karmazin-i-m/clock/(list of files, cad)

Other CAD files:
Autocad_Model/1x12 2.54 pin mother/1x12 2.54 pin mother.dwg
Autocad_Model/Clock Model/Clock Middle Part.dwg
Autocad_Model/GNM-23881.dwg
Autocad_Model/GNM-23881/GNM-23881.dwg
Autocad_Model/Border with small stamp A4.dwg
Autocad_Model/Clock Model/Clock Button.dwg
Autocad_Model/Border with big stamp A4.dwg
Autocad_Model/Clock Model/Clock model.dwg
Autocad_Model/Clock Model/Clock Back Cover.dwg
Autocad_Model/Clock Model/Clock Facade.dwg
