karmazin-i-m/clock/(list of files, drawings)

Other design files:
Clock/Arduino Nano 3/Arduino Nano 3.pdsprj
