karmazin-i-m/clock/Clock_Arduino/Clock_Arduino.ino

// Board variant. Set to 0 for a board fitted with a BMP280, which measures
// temperature and pressure but has no humidity sensor. Guarded so a build can
// override it, e.g. arduino-cli --build-property
// compiler.cpp.extra_flags=-DHAS_HUMIDITY=0
#ifndef HAS_HUMIDITY
#define HAS_HUMIDITY 1
#endif

#include <DS3231.h>
#include <Adafruit_Sensor.h>
#if HAS_HUMIDITY
#include <Adafruit_BME280.h>
#else
#include <Adafruit_BMP280.h>
#endif
#include <Wire.h>
#include <EEPROM.h>
#include <avr/pgmspace.h>

#define ButtonPin 2
#define LatchPin 4
#define ClockPin 3
#define AnodeDataPin 5
#define CatodeDataPin 7
#define CatodeClockPin 6

#define RENDER_LINE_COUNT 8

#if HAS_HUMIDITY
#define MARQUEE_PAGE_COUNT 5
#else
#define MARQUEE_PAGE_COUNT 4
#endif
#define MARQUEE_PAGE_BYTES 3
#define MARQUEE_STRIP_BYTES (MARQUEE_PAGE_COUNT * MARQUEE_PAGE_BYTES)
#define MARQUEE_PAGE_COLUMNS 24
#define MARQUEE_TOTAL_STEPS ((MARQUEE_PAGE_COUNT - 1) * MARQUEE_PAGE_COLUMNS)
#define MARQUEE_STEP_MS 80
#define MARQUEE_HOLD_MS 5000
#define MARQUEE_PERIOD_MINUTES 5

// Rows are advanced by Timer1, not by loop(), so the slot really is fixed and
// brightness no longer depends on what else the pass happened to do. Dimming is
// simply a shorter lit fraction of that same slot, which leaves the frame rate
// alone. Timer1 runs on the /8 prescaler, so one tick is 0.5 us at 16 MHz.
#define ROW_PERIOD_US 500
#define ROW_ON_BRIGHT_US 450
#define ROW_ON_DIM_US 60
#define TIMER1_TICKS_PER_US 2
#define ROW_PERIOD_TICKS (ROW_PERIOD_US * TIMER1_TICKS_PER_US)
#define FRAME_PERIOD_MS ((ROW_PERIOD_US * 8UL) / 1000)

// Defaults only. The ESP-01 can change the dimming window and the marquee
// period over the link, and what it sets is kept in EEPROM, so these are what a
// blank chip starts from.
#define DIM_FROM_HOUR 22
#define DIM_UNTIL_HOUR 7

#define CLOCK_POLL_MS 100
// Every sensor read is blocking I2C in the gap between two frames, so it costs
// the panel a dark window and shows up as a brightness dip. At one second the
// dip was a visible flicker and it bought nothing: the sensor itself converts
// in ~112 ms and every screen rounds to whole degrees, mmHg and percent.
#define SENSOR_POLL_MS 10000

// The ESP-01 on the hardware UART. Frames are one line of ASCII ending in a XOR
// checksum, and anything that fails it is dropped without a reply - the ESP's
// boot ROM talks at 74880 baud on this same wire every time it starts, and that
// noise must never be mistaken for a command.
//
// A reply has to fit in the 64 byte hardware transmit buffer - 63 usable - or
// Serial.print blocks loop() until the wire drains, at about a millisecond a
// byte. Two replies can leave in one pass, because the ESP polls for readings
// and settings on schedules that coincide, so the pair is what has to fit: a
// status frame is at most 40 bytes on the wire and a config frame 16.
#define LINK_BAUD 9600
#define LINK_BUFFER 48

// Signature, version, then the three settable bytes. A chip that does not carry
// the signature keeps the compiled defaults rather than three bytes of 0xFF.
#define CONFIG_ADDRESS 0
#define CONFIG_SIGNATURE_A 'K'
#define CONFIG_SIGNATURE_B 'C'
#define CONFIG_VERSION 1

// Twelve samples a quarter of an hour apart give the three hour window that
// pressure trends are conventionally read over.
#define PRESSURE_HISTORY 12
#define PRESSURE_SAMPLE_MS 900000UL
#define PRESSURE_TREND_MMHG 1

// One click steps through the screens. Holding does something only on the clock
// screen, where it opens time programming, and inside programming, where it moves
// to the next field. Entering takes the full three seconds so it cannot happen by
// accident; once inside, a second is enough and keeps setting a time bearable.
//
// The button is wired active HIGH. D2 was measured idling LOW in 100% of samples
// with the internal pull-up enabled and nothing pressed, and with zero edges, so
// an external pull-down holds the line and pressing lifts it. Reading it the other
// way round makes the firmware believe the button is held from the moment it boots.
#define BUTTON_PRESSED_LEVEL HIGH

#define BUTTON_DEBOUNCE_MS 25
#define BUTTON_HOLD_MS 3000
#define BUTTON_FIELD_HOLD_MS 1000

// Ten seconds, which is deliberately nowhere near the three that open time
// programming: this is the escape hatch for a router that was replaced, and it
// throws away a working network, so it must not be reachable by holding a
// moment too long.
#define BUTTON_RESET_HOLD_MS 10000

// The longest silence the ESP may ask for. Generous enough to cover walking the
// module into its bootloader by hand, and short enough that a frame sent by
// mistake cannot take the clock off the wire for the rest of the day.
#define LINK_MUTE_MAX_SECONDS 600

// A sensor screen returns to the clock once the button has been left alone this
// long. Programming is exempt: it is a deliberate mode the user is standing in
// front of, and dropping out of it mid-edit would be worse than waiting.
#define IDLE_RETURN_MS 30000

#if HAS_HUMIDITY
#define DISPLAY_MODE_COUNT 4
#else
#define DISPLAY_MODE_COUNT 3
#endif

const int times = 0;
const int temperature = 1;
const int pressure = 2;
#if HAS_HUMIDITY
const int humidity = 3;
#endif
const int altitude = 4;
const int marquee = 5;
const int settings = 100;
const int minuteMinorSettings = 101;
const int minuteMajorSettings = 102;
const int hourMinorSettings = 103;
const int hourMajorSettings = 104;
const int endSettings = 105;

const int colon = 10;
const int degree = 11;
const int celsius = 12;
const int pressureSymbol= 13;
const int nullNumber = 14;
const int percent = 15;
const int trendUp = 16;
const int trendDown = 17;
const int trendSteady = 18;

void commitFrame();
static void startRendering();
void timeArrayFilling(int hour1 = nullNumber, int hour2 = nullNumber, int minute1 = nullNumber, int minute2 = nullNumber, int separator = colon);
void pressureArrayFiling(int pressure1, int pressure2, int pressure3, int trend = nullNumber);
void temperatureArrayFiling(int temperature1, int temperature2);
int concatenateInt(int major, int minor);
void updateButton(unsigned long now);
void buttonClick();
void buttonHold();
void readSensors();
void recordPressureSample();
int pressureTrendGlyph();
#if HAS_HUMIDITY
void humidityArrayFiling(int humidity1, int humidity2);
#endif
void startMarquee();
void marqueeCapturePage(int page);
void marqueeRender();
void updateLink();
void linkSend(const char *payload);
void loadConfig();
void saveConfig();
static bool dimmedAt(uint8_t hour);

DS3231 clk;
#if HAS_HUMIDITY
Adafruit_BME280 bme;
#else
Adafruit_BMP280 bme;
#endif
RTCDateTime dt;

// Read by the row interrupt, written by loop(). Sixteen bit, so loop() has to
// write it with interrupts off or the interrupt can catch half of a new value.
volatile uint16_t rowOnTicks = ROW_ON_BRIGHT_US * TIMER1_TICKS_PER_US;

float sensorTemperature;
float sensorPressure;
#if HAS_HUMIDITY
float sensorHumidity;
#endif
unsigned long sensorReadTime;
unsigned long clockReadTime;
unsigned long frameComposeTime;

// Settable from the ESP, persisted in EEPROM, seeded from the defines above.
uint8_t dimFromHour = DIM_FROM_HOUR;
uint8_t dimUntilHour = DIM_UNTIL_HOUR;
uint8_t marqueePeriodMinutes = MARQUEE_PERIOD_MINUTES;

char linkBuffer[LINK_BUFFER];
uint8_t linkLength;
bool linkOverflow;

int pressureHistory[PRESSURE_HISTORY];
uint8_t pressureHistoryCount;
uint8_t pressureHistoryHead;
unsigned long pressureSampleTime;

void setup() {
  pinMode(LatchPin, OUTPUT);
  pinMode(ClockPin, OUTPUT);
  pinMode(AnodeDataPin, OUTPUT);
  pinMode(CatodeClockPin, OUTPUT);
  pinMode(CatodeDataPin, OUTPUT);
  pinMode(ButtonPin, INPUT_PULLUP);
  
  clk.begin();
  //clk.setDateTime(__DATE__, __TIME__);

  unsigned status;
  status = bme.begin(0x76);

  // Fast mode, which both the DS3231 and the BME280/BMP280 support. It has to
  // come last: clk.begin() and bme.begin() each call Wire.begin(), which reruns
  // twi_init and would put the bus back to 100 kHz. Four times the bus speed is
  // a quarter of the dark window that every blocking read punches in a frame.
  Wire.setClock(400000);
  
  Serial.begin(LINK_BAUD);
  loadConfig();

  // The first RTC read used to wait a hundred milliseconds for the timer in
  // loop(), which left the opening frames composing from an uninitialised dt.
  // Harmless when nobody was watching the first tenth of a second; not harmless
  // now that the ESP can ask for the time before then.
  dt = clk.getDateTime();

  readSensors();
  recordPressureSample();
  sensorReadTime = millis();
  pressureSampleTime = millis();

  startRendering();

  // Replaces the old "Initialized" banner, which was the one thing on this wire
  // the ESP could not parse. It also tells the ESP the clock restarted, so it
  // pushes the time again rather than waiting out its hour.
  linkSend("<B");
}

const uint8_t catode[8] PROGMEM = {2, 4, 8, 16, 32, 64, 128, 1};

uint8_t out[8][3] = {};

const uint8_t numeric[][8] PROGMEM = {
  {0x0F,0x09,0x09,0x09,0x09,0x09,0x0F,0x00},                  //0
  {0x02,0x06,0x0A,0x02,0x02,0x02,0x0F,0x00},                  //1
  {0x0F,0x01,0x01,0x0F,0x08,0x08,0x0F,0x00},                  //2
  {0x0F,0x01,0x01,0x0F,0x01,0x01,0x0F,0x00},                  //3
  {0x09,0x09,0x09,0x0F,0x01,0x01,0x01,0x00},                  //4
  {0x0F,0x08,0x08,0x0F,0x01,0x01,0x0F,0x00},                  //5
  {0x0F,0x08,0x08,0x0F,0x09,0x09,0x0F,0x00},                  //6
  {0x0F,0x01,0x02,0x04,0x04,0x04,0x04,0x00},                  //7
  {0x0F,0x09,0x09,0x0F,0x09,0x09,0x0F,0x00},                  //8
  {0x0F,0x09,0x09,0x0F,0x01,0x01,0x0F,0x00},                  //9
  {0x00,0x00,0x03,0x00,0x03,0x00,0x00,0x00},                  //=
  {0x07,0x05,0x07,0x00,0x00,0x00,0x00,0x00},                  //o
  {0x00,0x07,0x04,0x04,0x04,0x04,0x07,0x00},                  //c
  {0x0F,0x09,0x09,0x0F,0x08,0x08,0x08,0x00},                  //p
  {0x00,0x00,0x00,0x00,0x00,0x00,0x00,0x00},                  //null
  {0x71,0x52,0x74,0x08,0x17,0x25,0x47,0x00},                  //%
  {0x02,0x07,0x02,0x02,0x02,0x02,0x02,0x00},                  //trend up
  {0x02,0x02,0x02,0x02,0x02,0x07,0x02,0x00},                  //trend down
  {0x00,0x00,0x00,0x07,0x00,0x00,0x00,0x00},                  //trend steady
};

static inline uint8_t glyph(int index, int row){
  return pgm_read_byte(&numeric[index][row]);
}

long blinkTimeSettings;
int state = 0;

bool buttonRaw;
bool buttonStable;
bool buttonHoldFired;
bool buttonResetFired;

// Rollover safe as a pair: the comparison is always a subtraction of two
// millis() values, never a stored deadline that wraps.
unsigned long linkMuteStart;
unsigned long linkMuteMs;
bool linkOffline;
unsigned long buttonEdgeTime;
unsigned long buttonPressTime;
unsigned long buttonActivityTime;

int minute_minore;
int minute_major;

int hour_minore;
int hour_major;

uint8_t marqueeStrip[8][MARQUEE_STRIP_BYTES];
int marqueeStep;
unsigned long marqueeStepTime;
int lastMarqueeMinute = -1;

void loop() {
  unsigned long now = millis();
  
  updateButton(now);
  updateLink();

  // The marquee is left alone as well: it runs on its own clock and already ends
  // on the clock screen, so timing it out would only truncate it.
  if(state > times && state < settings && state != marquee && now - buttonActivityTime >= IDLE_RETURN_MS){
    state = times;
  }
  
  // The sensor moves far slower than the display refreshes, and reading it in
  // every pass was the main reason the sensor screens looked dimmer than the
  // clock. Once a second is more than the readings are worth.
  if(now - sensorReadTime >= SENSOR_POLL_MS){
    sensorReadTime = now;
    readSensors();
  }
  
  if(now - pressureSampleTime >= PRESSURE_SAMPLE_MS){
    pressureSampleTime = now;
    recordPressureSample();
  }
  
  if(state < settings && state != marquee && now - clockReadTime >= CLOCK_POLL_MS){
    clockReadTime = now;
    dt = clk.getDateTime();
    uint16_t ticks = dimmedAt(dt.hour) ?
      ROW_ON_DIM_US * TIMER1_TICKS_PER_US : ROW_ON_BRIGHT_US * TIMER1_TICKS_PER_US;
    noInterrupts();
    rowOnTicks = ticks;
    interrupts();

    // A period of zero turns the marquee off, and guards the modulo besides.
    if(marqueePeriodMinutes > 0){
      if(dt.minute % marqueePeriodMinutes != 0){
        // Forgetting the last run as soon as the minute stops matching is what
        // makes a period of sixty work. Held instead, the single candidate
        // minute would equal lastMarqueeMinute for ever after the first run and
        // the marquee would never start again.
        lastMarqueeMinute = -1;
      }
      else if(dt.minute != lastMarqueeMinute){
        lastMarqueeMinute = dt.minute;
        startMarquee();
      }
    }
  }
  
  // Everything above still runs every pass, which is now microseconds rather
  // than the four milliseconds a software rendered frame used to cost - the
  // button only gets polled more finely for it. Composing a screen that often
  // would be pure waste though, because the interrupt consumes exactly one
  // frame per FRAME_PERIOD_MS, so the rest of the pass keeps the old cadence.
  if(now - frameComposeTime < FRAME_PERIOD_MS){
    return;
  }
  frameComposeTime = now;
  
  switch(state){
    case times:
    {
      minute_minore = dt.minute % 10;
      minute_major = dt.minute / 10;
      
      hour_minore = dt.hour % 10;
      hour_major = dt.hour / 10;
      
      timeArrayFilling(hour_major,hour_minore,minute_major,minute_minore,
                       (dt.second & 1) ? colon : nullNumber);
    }
    break;
    case temperature:
    {
      int temperature = int(sensorTemperature);
      
      int temperature_minore = temperature % 10;
      int temperature_major = temperature / 10;
      
      temperatureArrayFiling(temperature_major,temperature_minore);
    }
    break;
    case pressure:
    {
      int pressure = int(sensorPressure);
      
      int pressure1 = pressure / 100;
      int pressure2 = pressure % 100 / 10;
      int pressure3 = pressure % 10;
      
      pressureArrayFiling(pressure1, pressure2, pressure3, pressureTrendGlyph());
    }
    break;
#if HAS_HUMIDITY
    case humidity:
    {
      int humidity = int(sensorHumidity);
      
      int humidity_minore = humidity % 10;
      int humidity_major = humidity / 10;
      
      humidityArrayFiling(humidity_major, humidity_minore);
    }
    break;
#endif
    case marquee:
    {
      // The last page is the clock again, so hand straight back to `times` on arrival
      // instead of dwelling on a copy of the time captured half a minute ago.
      if(marqueeStep >= MARQUEE_TOTAL_STEPS){
        state = times;
        break;
      }
      
      // A step that has just brought a whole screen into view dwells before moving on.
      unsigned long interval = MARQUEE_STEP_MS;
      
      if(marqueeStep > 0 && marqueeStep % MARQUEE_PAGE_COLUMNS == 0){
        interval = MARQUEE_HOLD_MS;
      }
      
      if(millis() - marqueeStepTime >= interval){
        marqueeStepTime = millis();
        marqueeStep++;
      }
      
      marqueeRender();
    }
    break;
    case settings:
    {
      dt = clk.getDateTime();
      
      minute_minore = dt.minute % 10;
      minute_major = dt.minute / 10;
      
      hour_minore = dt.hour % 10;
      hour_major = dt.hour / 10;
      
      state++;
    }
    break;
    case minuteMinorSettings:
    {
      long difference = millis() - blinkTimeSettings;
      
      if(difference > 1000){
        blinkTimeSettings = millis();
        break;
      }
      if(difference > 500 ){
        timeArrayFilling(hour_major,hour_minore,minute_major,nullNumber);
        break;
      }
      if(difference > 0){
        timeArrayFilling(hour_major,hour_minore,minute_major,minute_minore);
        break;;
      }
    }break;
    case minuteMajorSettings:
    {
      long difference = millis() - blinkTimeSettings;
      
      if(difference > 1000){
        blinkTimeSettings = millis();
        break;
      }
      if(difference > 500 ){
        timeArrayFilling(hour_major,hour_minore,nullNumber,minute_minore);
        break;
      }
      if(difference > 0){
        timeArrayFilling(hour_major,hour_minore,minute_major,minute_minore);
        break;
      }
    }break;
    case hourMinorSettings:
    {
      long difference = millis() - blinkTimeSettings;
      
      if(difference > 1000){
        blinkTimeSettings = millis();
        break;
      }
      if(difference > 500 ){
        timeArrayFilling(hour_major,nullNumber,minute_major,minute_minore);
        break;
      }
      if(difference > 0){
        timeArrayFilling(hour_major,hour_minore,minute_major,minute_minore);
        break;;
      }
    }break;
    case hourMajorSettings:
    {
      long difference = millis() - blinkTimeSettings;
      
      if(difference > 1000){
        blinkTimeSettings = millis();
        break;
      }
      if(difference > 500 ){
        timeArrayFilling(nullNumber,hour_minore,minute_major,minute_minore);
        break;
      }
      if(difference > 0){
        timeArrayFilling(hour_major,hour_minore,minute_major,minute_minore);
        break;;
      }
    }break;
    case endSettings:
    {
      clk.setDateTime(dt.year, dt.month, dt.day, concatenateInt(hour_major, hour_minore), concatenateInt(minute_major,minute_minore), 0);
      state ++;
    }
    default:
    state = 0;
    break;
  }
  
  commitFrame();
}

// All five display pins sit on PORTD, so the registers can be clocked with
// single cycle sbi/cbi instead of digitalWrite. Only our own bits are touched,
// which leaves the serial pins and the button pull-up on PD2 alone.
#define LATCH_BIT   (1 << LatchPin)
#define CLOCK_BIT   (1 << ClockPin)
#define ANODE_BIT   (1 << AnodeDataPin)
#define CAT_CLK_BIT (1 << CatodeClockPin)
#define CAT_DAT_BIT (1 << CatodeDataPin)

static void shiftCatode(uint8_t value){
  for(uint8_t bit = 0; bit < 8; bit++){
    if(value & 1){ PORTD |= CAT_DAT_BIT; } else { PORTD &= ~CAT_DAT_BIT; }
    PORTD |= CAT_CLK_BIT;
    PORTD &= ~CAT_CLK_BIT;
    value >>= 1;
  }
}

static void shiftAnode(uint8_t value){
  for(uint8_t bit = 0; bit < 8; bit++){
    if(value & 0x80){ PORTD |= ANODE_BIT; } else { PORTD &= ~ANODE_BIT; }
    PORTD |= CLOCK_BIT;
    PORTD &= ~CLOCK_BIT;
    value <<= 1;
  }
}

static void latchRow(uint8_t byte0, uint8_t byte1, uint8_t byte2, uint8_t row){
  PORTD &= ~LATCH_BIT;
  shiftCatode(byte0);
  shiftCatode(byte1);
  shiftCatode(byte2);
  shiftAnode(row);
  PORTD |= LATCH_BIT;
}

// The frame the interrupt actually latches. loop() keeps composing into out[][]
// exactly as before and publishes the result here in one go, so a row can never
// be latched from a screen that is half rebuilt.
volatile uint8_t frame[8][3] = {};
static volatile uint8_t renderRow = 0;

// Rows used to be advanced by a delay loop inside loop(), which fixed the lit
// time per row but not the period of a frame: any blocking work - an I2C read
// of the RTC or the sensor - stretched the frame while the panel was dark, and
// showed up as a brightness dip. Timer1 now advances the rows on its own, so a
// blocking pass costs nothing visible and brightness is genuinely
// rowOnTicks / ROW_PERIOD_TICKS.
//
// COMPA is the start of a row slot and latches it lit, COMPB lands rowOnTicks
// later and blanks it. ROW_ON_DIM_US has to stay comfortably above the ~37 us
// that latchRow spends shifting, or COMPB would fire while COMPA is still busy.
ISR(TIMER1_COMPA_vect){
  uint8_t row = renderRow;
  OCR1B = rowOnTicks;
  latchRow(frame[row][0], frame[row][1], frame[row][2], pgm_read_byte(&catode[row]));
}

ISR(TIMER1_COMPB_vect){
  latchRow(0, 0, 0, 0);
  renderRow = (renderRow + 1) & 7;
}

// CTC on OCR1A with the /8 prescaler: the slot is exactly ROW_PERIOD_TICKS and
// does not drift with what loop() is doing. Started after pinMode(), so the
// interrupt never shifts into a port that is still an input.
static void startRendering(){
  noInterrupts();
  TCCR1A = 0;
  TCCR1B = (1 << WGM12) | (1 << CS11);
  TCNT1 = 0;
  OCR1A = ROW_PERIOD_TICKS - 1;
  OCR1B = rowOnTicks;
  TIMSK1 = (1 << OCIE1A) | (1 << OCIE1B);
  interrupts();
}

// Twenty four bytes with interrupts off, which delays a row edge by a few
// microseconds out of five hundred and is the same cost on every pass.
void commitFrame(){
  noInterrupts();
  memcpy((void *)frame, out, sizeof(out));
  interrupts();
}

void timeArrayFilling(int hour1, int hour2, int minute1, int minute2, int separator){
  for (int i = 0; i<8 ; i++)
  {
    out[i][0] = (glyph(minute2,i)<<1) + (glyph(minute1,i)<<6);
    out[i][1] = (glyph(hour2,i)<<6) + (glyph(minute1,i)>>2) + (glyph(separator,i)<<3);
    out[i][2] = (glyph(hour1,i)<<3) + (glyph(hour2,i)>>2);
  }
}

void temperatureArrayFiling(int temperature1, int temperature2){
  for (int i = 0; i<8 ; i++)
  {
    out[i][0] = (glyph(celsius,i)<<1) + (glyph(degree,i)<<5);
    out[i][1] = (glyph(temperature1,i)<<6) + (glyph(temperature2,i)<<1);
    out[i][2] = (glyph(temperature1,i)>>2);
  }
}

void pressureArrayFiling(int pressure1, int pressure2, int pressure3, int trend){
  for (int i = 0; i<8 ; i++)
  {
    out[i][0] = (glyph(pressureSymbol,i)<<1) + (glyph(pressure3,i)<<6);
    out[i][1] = (glyph(pressure2,i)<<3) + (glyph(pressure3,i)>>2);
    out[i][2] = glyph(pressure1,i) + (glyph(trend,i)<<4);
  }
}

#if HAS_HUMIDITY
void humidityArrayFiling(int humidity1, int humidity2){
  for (int i = 0; i<8 ; i++)
  {
    out[i][0] = (glyph(percent,i)<<1);
    out[i][1] = (glyph(humidity1,i)<<6) + (glyph(humidity2,i)<<1);
    out[i][2] = (glyph(humidity1,i)>>2);
  }
}
#endif

void readSensors(){
  sensorTemperature = bme.readTemperature();
  sensorPressure = bme.readPressure() / 133.0F;
#if HAS_HUMIDITY
  sensorHumidity = bme.readHumidity();
#endif
}

void recordPressureSample(){
  pressureHistory[pressureHistoryHead] = int(sensorPressure);
  pressureHistoryHead = (pressureHistoryHead + 1) % PRESSURE_HISTORY;
  
  if(pressureHistoryCount < PRESSURE_HISTORY){
    pressureHistoryCount++;
  }
}

// Compares against the oldest sample held, so the arrow appears after the first
// quarter of an hour and widens to the full three hour window as the ring fills.
int pressureTrendGlyph(){
  if(pressureHistoryCount < 2){
    return nullNumber;
  }
  
  int oldest = pressureHistory[pressureHistoryCount < PRESSURE_HISTORY ? 0 : pressureHistoryHead];
  int delta = int(sensorPressure) - oldest;
  
  if(delta >= PRESSURE_TREND_MMHG){
    return trendUp;
  }
  if(delta <= -PRESSURE_TREND_MMHG){
    return trendDown;
  }
  return trendSteady;
}

void startMarquee(){
  int hour1 = dt.hour / 10;
  int hour2 = dt.hour % 10;
  int minute1 = dt.minute / 10;
  int minute2 = dt.minute % 10;
  
  int page = 0;
  
  timeArrayFilling(hour1, hour2, minute1, minute2);
  marqueeCapturePage(page++);
  
  int temperatureNow = int(sensorTemperature);
  temperatureArrayFiling(temperatureNow / 10, temperatureNow % 10);
  marqueeCapturePage(page++);
  
  int pressureNow = int(sensorPressure);
  pressureArrayFiling(pressureNow / 100, pressureNow % 100 / 10, pressureNow % 10, pressureTrendGlyph());
  marqueeCapturePage(page++);
  
#if HAS_HUMIDITY
  int humidityNow = int(sensorHumidity);
  humidityArrayFiling(humidityNow / 10, humidityNow % 10);
  marqueeCapturePage(page++);
#endif
  
  timeArrayFilling(hour1, hour2, minute1, minute2);
  marqueeCapturePage(page++);
  
  marqueeStep = 0;
  marqueeStepTime = millis();
  state = marquee;
}

// Page 0 is shown first, so it sits at the high (left) end of the strip.
void marqueeCapturePage(int page){
  int base = MARQUEE_PAGE_BYTES * (MARQUEE_PAGE_COUNT - 1 - page);
  
  for (int i = 0; i<8 ; i++)
  {
    marqueeStrip[i][base + 0] = out[i][0];
    marqueeStrip[i][base + 1] = out[i][1];
    marqueeStrip[i][base + 2] = out[i][2];
  }
}

// Copy the visible 24 column window out of the strip, one column further right each step.
void marqueeRender(){
  int shift = MARQUEE_TOTAL_STEPS - marqueeStep;
  int byteIndex = shift / 8;
  int bitOffset = shift % 8;
  
  for (int i = 0; i<8 ; i++)
  {
    for (int b = 0; b<MARQUEE_PAGE_BYTES ; b++)
    {
      int value = marqueeStrip[i][byteIndex + b] >> bitOffset;
      
      if(bitOffset){
        value |= marqueeStrip[i][byteIndex + b + 1] << (8 - bitOffset);
      }
      
      out[i][b] = value & 0xFF;
    }
  }
}

int concatenateInt(int major, int minor){
  return (major*10) + minor;
}

// The window wraps midnight in the default case - twenty two to seven - but
// nothing stops the ESP setting a daytime one, so both orders have to work. The
// old expression only handled the wrapping case and would have dimmed around
// the clock for, say, seven to twenty two.
//
// Both ends are boundaries on a 0..24 line, not hours of the day, and the end
// is half open. That is what lets the two extremes be said at all: 0 to 24
// dims around the clock, and any pair that is equal - 0 to 0, 24 to 24 - never
// dims. Twenty four is legal at the start too, where it simply reads as the
// far end and so behaves like zero.
static bool dimmedAt(uint8_t hour){
  if(dimFromHour == dimUntilHour){
    return false;
  }

  if(dimFromHour > dimUntilHour){
    return hour >= dimFromHour || hour < dimUntilHour;
  }

  return hour >= dimFromHour && hour < dimUntilHour;
}

void loadConfig(){
  if(EEPROM.read(CONFIG_ADDRESS) != CONFIG_SIGNATURE_A ||
     EEPROM.read(CONFIG_ADDRESS + 1) != CONFIG_SIGNATURE_B ||
     EEPROM.read(CONFIG_ADDRESS + 2) != CONFIG_VERSION){
    return;
  }

  uint8_t from = EEPROM.read(CONFIG_ADDRESS + 3);
  uint8_t until = EEPROM.read(CONFIG_ADDRESS + 4);
  uint8_t period = EEPROM.read(CONFIG_ADDRESS + 5);

  if(from <= 24){ dimFromHour = from; }
  if(until <= 24){ dimUntilHour = until; }
  if(period <= 60){ marqueePeriodMinutes = period; }
}

// update() rather than write(), so a value that has not changed costs nothing
// and the cell is not worn down by a form that was submitted unaltered. Each
// byte that does change stalls this function for ~3.3 ms, but with interrupts
// on, so the panel keeps refreshing throughout.
void saveConfig(){
  EEPROM.update(CONFIG_ADDRESS, CONFIG_SIGNATURE_A);
  EEPROM.update(CONFIG_ADDRESS + 1, CONFIG_SIGNATURE_B);
  EEPROM.update(CONFIG_ADDRESS + 2, CONFIG_VERSION);
  EEPROM.update(CONFIG_ADDRESS + 3, dimFromHour);
  EEPROM.update(CONFIG_ADDRESS + 4, dimUntilHour);
  EEPROM.update(CONFIG_ADDRESS + 5, marqueePeriodMinutes);
}

// Nothing the clock has to say is worth a corrupted image, so the gate sits here
// rather than at each call site - the boot frame and the ten second reset go
// through it too.
static bool linkMuted(){
  return linkMuteMs > 0 && millis() - linkMuteStart < linkMuteMs;
}

void linkSend(const char *payload){
  if(linkMuted()){
    return;
  }

  uint8_t sum = 0;
  for(const char *p = payload; *p; p++){
    sum ^= (uint8_t)*p;
  }

  Serial.print(payload);
  Serial.print('*');
  if(sum < 0x10){
    Serial.print('0');
  }
  Serial.println(sum, HEX);
}

static int linkHexDigit(char c){
  if(c >= '0' && c <= '9'){ return c - '0'; }
  if(c >= 'A' && c <= 'F'){ return c - 'A' + 10; }
  if(c >= 'a' && c <= 'f'){ return c - 'a' + 10; }
  return -1;
}

// Trims the checksum off the line and says whether it matched.
static bool linkVerify(char *line){
  char *star = strrchr(line, '*');
  if(star == NULL || strlen(star) != 3){
    return false;
  }

  int high = linkHexDigit(star[1]);
  int low = linkHexDigit(star[2]);
  if(high < 0 || low < 0){
    return false;
  }

  uint8_t given = (uint8_t)(high * 16 + low);
  *star = '\0';

  uint8_t sum = 0;
  for(char *p = line; p < star; p++){
    sum ^= (uint8_t)*p;
  }

  return sum == given;
}

static int linkDigits(const char *p, uint8_t count){
  int value = 0;
  for(uint8_t i = 0; i < count; i++){
    if(p[i] < '0' || p[i] > '9'){
      return -1;
    }
    value = value * 10 + (p[i] - '0');
  }
  return value;
}

// " 2026-09-21 14:03:22", fixed width. The ESP is the only thing that speaks
// this, so being strict costs nothing and rejects noise for free.
static void linkSetTime(const char *args){
  // Length first. updateLink() reuses linkBuffer without clearing it, so a
  // short frame that passed its checksum would otherwise have the separator
  // test reading the tail of whatever longer frame came before.
  if(strlen(args) < 20){
    linkSend("<E");
    return;
  }

  if(args[0] != ' ' || args[5] != '-' || args[8] != '-' ||
     args[11] != ' ' || args[14] != ':' || args[17] != ':'){
    linkSend("<E");
    return;
  }

  int year = linkDigits(args + 1, 4);
  int month = linkDigits(args + 6, 2);
  int day = linkDigits(args + 9, 2);
  int hour = linkDigits(args + 12, 2);
  int minute = linkDigits(args + 15, 2);
  int second = linkDigits(args + 18, 2);

  if(year < 2000 || month < 1 || month > 12 || day < 1 || day > 31 ||
     hour > 23 || minute > 59 || second > 59 ||
     hour < 0 || minute < 0 || second < 0){
    linkSend("<E");
    return;
  }

  // Being overruled mid edit by a frame off the wire would be worse than the
  // few seconds of drift that waiting costs.
  if(state >= settings){
    linkSend("<E");
    return;
  }

  clk.setDateTime(year, month, day, hour, minute, second);
  dt = clk.getDateTime();
  linkSend("<K");
}

static void linkSendStatus(){
  int humidityValue = -1;
#if HAS_HUMIDITY
  if(!isnan(sensorHumidity)){
    humidityValue = constrain(int(sensorHumidity), 0, 100);
  }
#endif

  // Clamped, and not for tidiness: bme.begin() discards its status, so a sensor
  // that never answered leaves these NaN, and int(NaN) on this compiler is
  // -32768. Six characters in each of three fields would push the frame past
  // what the transmit buffer can hold alongside a second reply in the same pass.
  int temperatureTenths = isnan(sensorTemperature) ? -999 : constrain(int(sensorTemperature * 10), -999, 999);
  int pressureValue = isnan(sensorPressure) ? -1 : constrain(int(sensorPressure), 0, 9999);

  // dt is only refreshed while a clock family screen is showing, so during a
  // marquee or a programming session it would reach the web page minutes stale.
  // Read the RTC straight into a local for those - not over dt, which case
  // settings has latched the date out of.
  RTCDateTime stamp = (state >= settings || state == marquee) ? clk.getDateTime() : dt;

  // Temperature travels in tenths of a degree as a plain integer: formatting a
  // float on this chip costs over a kilobyte of flash and buys nothing, since
  // the ESP only has to divide it again.
  char body[56];
  snprintf(body, sizeof(body), "<S %04u-%02u-%02u %02u:%02u:%02u %d %d %d",
    (unsigned)stamp.year, (unsigned)stamp.month, (unsigned)stamp.day,
    (unsigned)stamp.hour, (unsigned)stamp.minute, (unsigned)stamp.second,
    temperatureTenths, pressureValue, humidityValue);

  linkSend(body);
}

static void linkSendConfig(){
  char body[32];
  snprintf(body, sizeof(body), "<C %u %u %u",
    (unsigned)dimFromHour, (unsigned)dimUntilHour, (unsigned)marqueePeriodMinutes);

  linkSend(body);
}

static void linkSetConfig(char *args){
  while(*args == ' '){
    args++;
  }

  char *value = strchr(args, ' ');
  if(value == NULL){
    linkSend("<E");
    return;
  }
  *value++ = '\0';

  int number = atoi(value);

  if(strcmp(args, "dimfrom") == 0 && number >= 0 && number <= 24){
    dimFromHour = number;
  }
  else if(strcmp(args, "dimuntil") == 0 && number >= 0 && number <= 24){
    dimUntilHour = number;
  }
  else if(strcmp(args, "marquee") == 0 && number >= 0 && number <= 60){
    marqueePeriodMinutes = number;
  }
  else {
    linkSend("<E");
    return;
  }

  saveConfig();
  linkSend("<K");
}

// ">M 300" - the ESP is about to be flashed over the cable, and the clock's D1
// would be fighting the USB bridge for its RX line the whole time. Everything
// is digits only and bounded, because the one thing worse than a noisy wire is
// a clock that has talked itself into silence.
static void linkMute(const char *args){
  if(*args != ' '){
    linkSend("<E");
    return;
  }

  args++;
  long seconds = 0;
  const char *p = args;
  if(*p == '\0'){
    linkSend("<E");
    return;
  }

  for(; *p; p++){
    if(*p < '0' || *p > '9'){
      linkSend("<E");
      return;
    }
    seconds = seconds * 10 + (*p - '0');
    if(seconds > LINK_MUTE_MAX_SECONDS){
      linkSend("<E");
      return;
    }
  }

  // Acknowledged before the gate closes, or the ESP would be left wondering
  // whether the frame arrived at all.
  linkSend("<K");
  Serial.flush();

  linkMuteStart = millis();
  linkMuteMs = (unsigned long)seconds * 1000UL;
}

static void handleLinkFrame(char *line){
  // Not addressed to us, so not even worth an error frame - this is where the
  // ESP's boot chatter lands.
  if(line[0] != '>' || !linkVerify(line)){
    return;
  }

  switch(line[1]){
    case 'T': linkSetTime(line + 2); break;
    case 'Q': linkSendStatus(); break;
    case 'G': linkSendConfig(); break;
    case 'C': linkSetConfig(line + 2); break;
    case 'M': linkMute(line + 2); break;
    default:  linkSend("<E"); break;
  }
}

// Called on every pass. At 9600 baud a byte arrives about once a millisecond
// and the hardware buffer holds sixty four of them, so loop() drains it many
// times over between arrivals and nothing here ever blocks.
void updateLink(){
  // Same correction as on the ESP: silence is not enough. D1 is TXD, driven
  // high by the UART, and while it is driving the ESP's RX no bridge can talk
  // to that pin cleanly. Clearing TXEN0 - which is what Serial.end() does -
  // hands the pin back to DDRD, and nothing in this sketch ever made it an
  // output, so it becomes a high impedance input. pinMode() says so out loud.
  bool muted = linkMuted();

  if(muted && !linkOffline){
    Serial.flush();
    Serial.end();
    pinMode(1, INPUT);
    linkOffline = true;
    linkLength = 0;
    linkOverflow = false;
    return;
  }

  if(!muted && linkOffline){
    Serial.begin(LINK_BAUD);
    linkOffline = false;
    linkLength = 0;
    linkOverflow = false;
  }

  if(linkOffline){
    return;
  }

  while(Serial.available()){
    char c = Serial.read();

    if(c == '\r'){
      continue;
    }

    if(c == '\n'){
      if(!linkOverflow && linkLength > 0){
        linkBuffer[linkLength] = '\0';
        handleLinkFrame(linkBuffer);
      }
      linkLength = 0;
      linkOverflow = false;
      continue;
    }

    // Swallow the rest of an over long line rather than splitting it into two
    // frames, either of which would then fail its checksum anyway.
    if(linkLength >= LINK_BUFFER - 1){
      linkOverflow = true;
      continue;
    }

    linkBuffer[linkLength++] = c;
  }
}

// Polled rather than interrupt driven. loop() now runs on a fixed ~4 ms cadence,
// which is ample for a button, and it keeps press timing out of an ISR entirely.
// The old handler did measure press duration correctly, but had no debounce: the
// chatter on release produced several falling edges a few milliseconds apart, and
// each one was taken for another short press, so the screens jumped in bursts.
void updateButton(unsigned long now){
  bool pressed = (digitalRead(ButtonPin) == BUTTON_PRESSED_LEVEL);
  
  if(pressed != buttonRaw){
    buttonRaw = pressed;
    buttonEdgeTime = now;
  }
  else if(pressed != buttonStable && now - buttonEdgeTime >= BUTTON_DEBOUNCE_MS){
    buttonStable = pressed;
    buttonActivityTime = now;
    
    if(pressed){
      buttonPressTime = now;
      buttonHoldFired = false;
      buttonResetFired = false;
    }
    else if(!buttonHoldFired){
      buttonClick();
    }
  }
  
  // A hold that lands on a screen which ignores it still suppresses the click,
  // so holding never quietly turns into a page step on release.
  if(buttonStable && !buttonHoldFired){
    unsigned long threshold = (state >= settings) ? BUTTON_FIELD_HOLD_MS : BUTTON_HOLD_MS;
    
    if(now - buttonPressTime >= threshold){
      buttonHoldFired = true;
      buttonHold();
    }
  }
  
  // Separate from buttonHoldFired on purpose. That latch has already fired by
  // now - the longest threshold above is three seconds - so this needs a latch
  // of its own, and it does not go through buttonHold(), which is per screen.
  // Ten seconds is the same gesture wherever it starts.
  if(buttonStable && !buttonResetFired && now - buttonPressTime >= BUTTON_RESET_HOLD_MS){
    buttonResetFired = true;
    linkSend("<R");
    
    // On the clock screen the three second threshold has already dropped us
    // into programming on the way past, so leave it - and leave it without
    // going through endSettings, which would write the half edited digits to
    // the RTC. Nothing is drawn about the reset: the clock knows only that it
    // sent a frame, and whether an ESP was even listening is not its business.
    state = times;
  }
}

void buttonClick(){
  if(state >= settings){
    switch(state){
      case minuteMinorSettings:
      {
        minute_minore ++;
        if(minute_minore == 10){
          minute_minore = 0;
        }
      }
      break;
      case minuteMajorSettings:
      {
        minute_major++;
        if(minute_major == 6){
          minute_major = 0;
        }
      }
      break;
      case hourMinorSettings:
      {
        hour_minore++;
        if(hour_minore == 10){
          hour_minore = 0;
        }
      }
      break;
      case hourMajorSettings:
      {
        hour_major++;
        if(hour_major == 3){
          hour_major = 0;
        }
      }
      break;
    }
    return;
  }
  
  // Steps the screens, and doubles as the way out of a running marquee.
  state++;
  
  if(state >= DISPLAY_MODE_COUNT){
    state = times;
  }
}

void buttonHold(){
  if(state == times){
    state = settings;
    return;
  }
  
  if(state >= settings){
    state++;
  }
}
