karmazin-i-m/clock/(commit log)

2021-06-12 Fix button delay
2026-09-13 Add a five minute marquee that slides through every screen
    On every fifth RTC minute the clock composes all five screens - time,
    temperature, pressure, humidity, time - into a 120 column strip and
    slides a 24 column window across it, dwelling five seconds on each
    screen once it has fully come into view.
    The marquee state id stays below `settings`, so the existing button
    handling still aborts it. It hands back to `times` on reaching the last
    page instead of dwelling on a clock captured twenty seconds earlier.
    The clock is now read once at the top of loop() rather than inside
    `case times`, so driving the marquee costs no extra I2C traffic on the
    time screen.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
2026-09-13 Add the BMP280 variant of the sketch
    Same firmware for boards fitted with a BMP280 instead of a BME280. The
    humidity branch is commented out and the screen renders a literal 00%.
    It does not carry the marquee.
2026-09-13 Fold the BMP280 variant into the main sketch behind HAS_HUMIDITY
    The separate copy of the firmware for BMP280 boards has been deleted; the
    one difference it carried is now a switch at the top of the sketch,
    guarded by #ifndef so a build can override it without editing the file.
    With HAS_HUMIDITY 0 the sensor class becomes Adafruit_BMP280 and the
    humidity screen is dropped outright rather than rendered as a literal
    00%: MARQUEE_PAGE_COUNT falls to 4, and `case humidity` disappears so the
    button cycle runs clock -> temperature -> pressure -> clock through the
    existing `default` reset.
    The HAS_HUMIDITY 1 build is byte for byte the same size as before this
    change, so the BME280 boards are unaf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
    [Clock_Arduino.ino]
2026-09-13 Even out brightness, cut SRAM, and add colon blink, trend and night dimming
    Display
    All five display pins are on PORTD, so the shift registers are now
    clocked with sbi/cbi rather than shiftOut/digitalWrite, touching only
    those five bits.
    More importantly, every row now gets an identical ROW_PERIOD_US slot
    and is blanked at the end of it. A row used to stay lit until the next
    one was latched, so the last row of a frame also burned through
    everything loop() did afterwards: the bottom line was brighter, by an
    amount that changed with the screen being shown.
    Brightness is therefore rowOnMicros / ROW_PERIOD_US, which is also the
    dimming mechanism - rowOnMicros drops to ROW_O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
    [Clock_Arduino.ino]
2026-09-13 Replace the button interrupt with a polled, debounced handler
    The old handler ran from an INT0 CHANGE interrupt with no debounce, and
    the interval it classified was the gap since the previous release rather
    than how long the button was held - the action fired on the press, when
    debounceInterrupt still held the time since the last rising edge. So
    contact bounce supplied its own 1-300 ms intervals and stepped through
    the screens on its own, entering programming depended on an accidental
    1-3 s pause between presses, and a press after more than 3 s of idle
    matched neither range and did nothing at all.
    It is now polled from loop(), which runs on a fixed ~4 ms cadence:
    click steps the screens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
    [Clock_Arduino.ino]
2026-09-13 Return to the clock after 30 s without button activity
    Any screen other than the clock falls back to it once the button has
    been left alone for IDLE_RETURN_MS. The countdown restarts on every
    debounced press or release, so it only fires on genuine idling.
    Programming is included on purpose: otherwise walking away mid-edit
    leaves the clock in a blinking settings screen for good. Leaving that way
    writes nothing to the RTC, so the edit is simply dropped.
    The marquee is excluded. It runs on its own clock and already ends on the
    clock screen, so timing it out would only truncate it.
    Verified on the host: a sensor screen still shown at 29 s and gone by 31,
    a click at 20 s restarting the countdo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
2026-09-13 Hold is three seconds everywhere, and programming never times out
    Both of these were my assumptions rather than requirements, and both were
    wrong.
    The separate in-programming hold threshold is gone rather than raised, so
    there is one BUTTON_HOLD_MS and no pair of identical constants to drift
    apart. Setting a time now costs four 3 s holds, which is the intended
    feel.
    The idle return no longer applies to programming: it is a deliberate mode
    the user is standing in front of, and dropping out mid-edit is worse than
    leaving the screen up. The guard is now `state < settings`, so only the
    sensor screens fall back to the clock.
    [Clock_Arduino.ino]
2026-09-13 Read the button as active HIGH, which is how it is actually wired
    Booting went straight into time programming with nobody touching the
    button. A probe sketch settles why: D2 idles LOW in 100% of samples, with
    zero edges, while nothing is pressed and the internal pull-up is on. An
    external pull-down holds the line and pressing lifts it - the button is
    active HIGH, and pinMode(..., INPUT_PULLUP) in setup() reads like the
    opposite.
    Taking LOW for pressed therefore meant the firmware believed the button
    was held from the moment it powered up, so the hold fired three seconds
    in and opened programming.
    This also corrects the record on the old interrupt handler. Its timing
    was right, not wrong: t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
    [Clock_Arduino.ino]
2026-09-13 Move between programming fields on a one second hold again
    Entering programming keeps the full three seconds so it cannot happen by
    accident, but once inside a second is enough, and it keeps setting a time
    from costing four three second holds.
    This is the same split that was removed a few commits ago as an
    unrequested assumption. It is now a preference confirmed on hardware,
    with a working button to try it on.
2026-09-13 Take the whole project under version control, not just the firmware
    The repository used to sit inside Clock_Arduino/ and track two files,
    while the enclosure drawings, the fabrication files, the simulation and
    the datasheet were not versioned at all. Its .git has been moved up to
    the project root rather than started afresh, so the existing history
    survives and the firmware appears as a rename rather than a delete and an
    add - and nothing already pushed has to be rewritten.
    Added a .gitignore for what these tools leave behind: AutoCAD .bak
    shadows, .dwl/.dwl2 locks and plot.log, Proteus "Backup Of" / "Last
    Loaded" .pdsbak copies, and the Proteus workspace file, which is per user
    and carries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
    [1x12 2.54 pin mother.dwg, Arduino Nano 3.pdsprj, Border with big stamp A4.dwg, Border with small stamp A4.dwg, Clock Back Cover.dwg, Clock Button.dwg, Clock Facade.dwg, Clock Middle Part.dwg]
2026-09-20 Drive the display multiplex from Timer1
    visual() ran once per loop() and fixed the lit time of a row, but nothing
    fixed the period of a frame. Every blocking I2C read therefore stretched a
    frame while the panel was already blanked, and the dark gap read as a dip in
    brightness: the sensor poll cost 3 ms on a 4.75 ms loop and showed up as a
    flicker once a second, the RTC poll cost 1.1 ms ten times a second and showed
    up as a shimmer.
    Timer1 now advances the rows on its own, in CTC mode on the /8 prescaler.
    COMPA opens a row slot and latches the row lit, COMPB lands rowOnTicks later
    and blanks it, so loop() can block for as long as it likes without the display
    noticing. Brightness is finally w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
    [Clock_Arduino.ino]
2026-09-21 Put the ESP-01 on the clock's UART
    The footprint in Gerber files/ has been waiting for firmware since 2021.
    Clock_ESP01/ fills it: a WiFiManager captive portal that a phone opens by
    itself, an NTP client that keeps the DS3231 honest, and a web page for the
    readings and the settings.
    The ESP is a peripheral. It owns nothing on the panel, and pulling it out
    leaves the clock behaving exactly as before. The hardware UART was the only
    transport available: SoftwareSerial cannot survive a Timer1 ISR that runs
    ~38 us twice every 500 us, and a second I2C master on the DS3231 bus has no
    arbitration to lose.
    Frames are one ASCII line ending in a XOR checksum. The checksum is not for
    noisy wires - it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
2026-09-23 Implement K-Clock Cloud server v1 per Server/DESIGN.md
    Scaffolds the full ASP.NET Core + PostgreSQL/TimescaleDB backend: KClock.Data
    (entities, ClockDbContext/IngestDbContext for the clock_app/clock_ingest role
    split, three migrations covering the hypertable, compression, RLS policies,
    security_barrier views and grants), KClock.Api (/d/v1 enroll+telemetry with
    the 512-byte response budget and device bearer auth, plus the /api browser
    API with Google sign-in and account-scoped RLS transactions), KClock.Tests
    (isolation/transfer and device-contract characterization tests), and
    KClock.FakeDevice, along with compose/Caddyfile/bootstrap SQL for deploy.
    Built without Docker available, so build-or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
2026-09-23 Fix the server defects a real TimescaleDB run exposed
    ffc3a62 was written without Docker, so none of it had run against a
    database. Running the tests on timescaledb-ha:pg17 turned up seven
    defects:
    - EF Core 10.0.12 resolved against Relational 10.0.4, so every query
    failed with FileNotFoundException. Pin Relational, and make MSB3277
    an error, since it was only a warning.
    - INSERT ... ON CONFLICT on the hypertable needs SELECT; grant it to
    clock_ingest. clock_app still has nothing on telemetry.
    - SqlQueryRaw<scalar> needs the column aliased "Value"; without it
    Google sign-in failed.
    - current_account_id() threw on a pooled connection, where the GUC
    reads '' after a scoped transacti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
2026-10-04 Serve an OpenAPI document and Swagger UI
    /openapi/v1.json and /swagger are on in Development and off elsewhere
    unless OpenApi:Enabled (OPENAPI_ENABLED in compose) says otherwise:
    the document describes every endpoint, including the device contract,
    and publishing it should be a decision rather than a default.
    Swagger UI is same-origin, so Try it out carries the session cookie,
    and a request interceptor adds the X-Requested-With header that
    RequestedWithCsrfFilter requires on every non-GET call under /api.
2026-10-04 Replace esp_version and nano_version with one fw_version
    The server talks only to the network module, and fw is that module's
    version; the kind of hardware is already device.profile. A column per
    chip would have meant a migration for every new component, and the
    Nano's version has no way to reach the server anyway. Both columns
    were also never written: enroll parsed fw and dropped it.
    Enrollment now upserts device_state.fw_version in its transaction. The
    telemetry request carries no fw, so the value is refreshed only by a
    re-enrollment.
    InitialSchema is edited in place because it has never been applied to
    a database that needs to be kept.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
2026-10-20 Add a TLS probe page and a size-checked ESP build
    /probe runs step one of Server/DESIGN.md §14 inside the real firmware:
    heap at idle and while a connection holds its buffers, two handshakes
    against the deployed server with ISRG Root YE and X2 as anchors, and an
    empty enroll to see the device path end to end. On the module the heap
    is ample, every handshake is a full one (no resumption between Caddy's
    tickets and BearSSL's session IDs), and it takes 4.0 s at 160 MHz.
    Flash is what bit: BearSSL took the image from 409 KB to 528 KB, which
    flashes once over the plain firmware and never again over itself.
    build.sh brings it to 499 KB with build.float=, -DWM_NODEBUG and
    xtal=160, and fails any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
2026-10-20 Retry the saved network after a power cut, and dark the LED online
    After a power cut the module boots long before the router, raises the
    portal, and WiFiManager switches the station side off while the portal
    runs. With a timeout of zero it never looked for the network again, and
    only a restart brought it back. With a network saved the portal now
    times out after 180 s unless a phone is on it, and loop() tries the
    saved network again, until the first connection; after that the SDK's
    auto-reconnect handles drops as before.
    The blue LED no longer flashes while online - at night it outshone the
    clock's dimmed panel. It still blinks while the portal is up.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
2026-10-20 Bind the ESP to the cloud with an enrollment code
    The settings page takes a code from the account, and loop() exchanges
    it over TLS at /d/v1/enroll once the module is online, has an NTP time
    to check the certificate against, and hears the clock, since the server
    fixes the sensor model at the first enrollment and only the Nano knows
    it. The token goes into EEPROM layout KCL3, which only appends to KCL2
    so the time zone and OTA password survive the upgrade. It is replaced
    only by a successful enrollment, never cleared by a refusal, and never
    shown; the status page says only whether one is held and what the last
    attempt returned.
    cloudPost() is the one HTTPS call telemetry will reuse, and repl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
2026-10-20 Send telemetry in batches from a RAM ring
    Every sample_s the last reading from the Nano goes into a 180-slot ring,
    stamped with NTP time, and every flush_s up to max_batch of the oldest
    go out in one POST /d/v1/telemetry - a handshake per sample would keep
    the module on the network a tenth of its life. The cadence comes from
    the server's policy on enroll and on every batch, sampling stays on its
    grid when a handshake delays one, and a backlog drains at one batch
    every few seconds once the server answers again.
    Status codes follow DESIGN.md §5.3: 400 drops the batch, 401/403/404
    hold for an hour and keep the token, 413 retries once at half size,
    429 honours Retry-After, the rest back off 1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
2026-10-21 Trust forwarded headers only from the configured proxy
    Clearing KnownProxies and KnownIPNetworks made X-Forwarded-For count from
    anyone who could reach port 8080, so a LAN client could pick its own
    address and with it its own enrollment rate-limit bucket. The API now
    trusts the addresses or CIDR networks in ReverseProxy:TrustedProxies and
    keeps ASP.NET's loopback-only default when that is unset. compose names
    the Docker bridge range so the local stack keeps working.
2026-10-24 Serve the cabinet's reads: readings, charts and former clocks
    The design in design/ needs more than v1's browser API gave it. Devices
    now carry their last reading and the pressure trend, computed by the
    firmware's own rule. New endpoints serve a 24 h summary, chart series
    with gaps marked by null rather than interpolated, and former clocks
    addressed by binding, since after A -> B -> A one device id names two
    ownership periods. Every telemetry query is narrowed to one binding on
    top of RLS for the same reason.
    Enrollment codes get an id and a status so the add page can wait for
    its own code to be used. /api/* answers 401 instead of redirecting a
    fetch() to Google, the browser API is snake_ca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
2026-10-24 Build the cabinet, its settings downlink and account deletion
    The cabinet in design/ is now a React + Vite + TypeScript SPA under
    Server/web, published into the API's wwwroot and served from the same
    origin. Unknown paths under /api, /d, /auth and /health stay 404s
    instead of falling through to index.html. The LED glyphs, chart gaps,
    night dimming rule and Ukrainian plurals have vitest coverage.
    The settings page writes to a new device_settings table keyed on the
    binding. Each change, the time zone included, takes a version from one
    global sequence. A telemetry reply whose cfgv differs from that version
    carries a "config" block: dimming bounds, marquee period, and the POSIX
    TZ rule read fro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
2026-10-24 Apply the cabinet's display settings on the ESP
    Every batch now reports cfgv, the version of the cloud's settings the
    module last applied, stored in EEPROM layout KCL4. KCL4 only appends
    the field, so a KCL3 module keeps its binding and starts from 0.
    When a reply carries "config", the module sends dimming and marquee to
    the Nano as the same >C frames its settings page uses, and moves NTP to
    the new zone. It records the version only while the link to the Nano
    is alive. The Nano's next <C is checked against what was sent, and a
    mismatch forgets the version, so the server sends the settings again.
    The image is 497552 bytes, 592 more than before and ~14 KB under the
    OTA ceiling. It was compil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
2026-10-24 Give telemetry_1h a refresh policy
    Every 30 minutes over the whole history, stopping an hour short of now.
    A finite start_offset would lift the watermark over history it never
    materialised and drop it from every chart; the new test fails that way.
    The purge now stops where the policy does instead of three hours back,
    and the test container runs no job scheduler so tests stay deterministic.
